sjorspeterse/Arduino_Chess/Other/Foto's/CAM00485.jpg

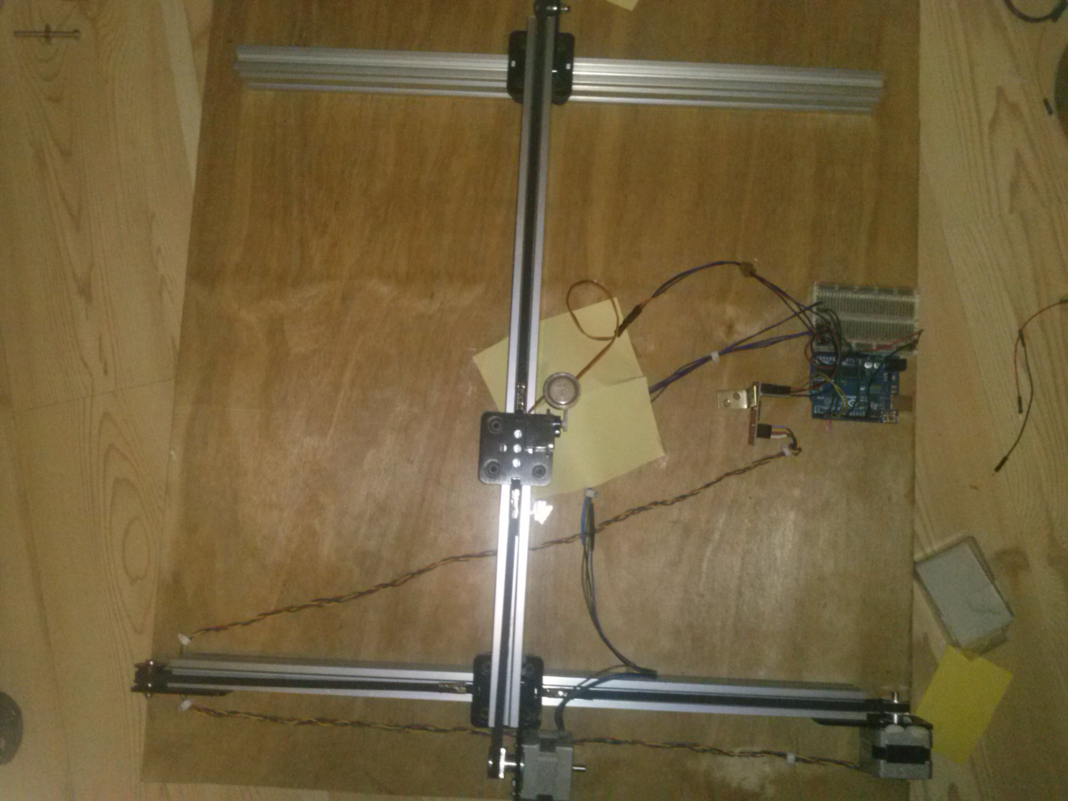
Other/Foto's/CAM00485.jpg
