sjorspeterse/Arduino_Chess/Other/Foto's/CAM00478.jpg

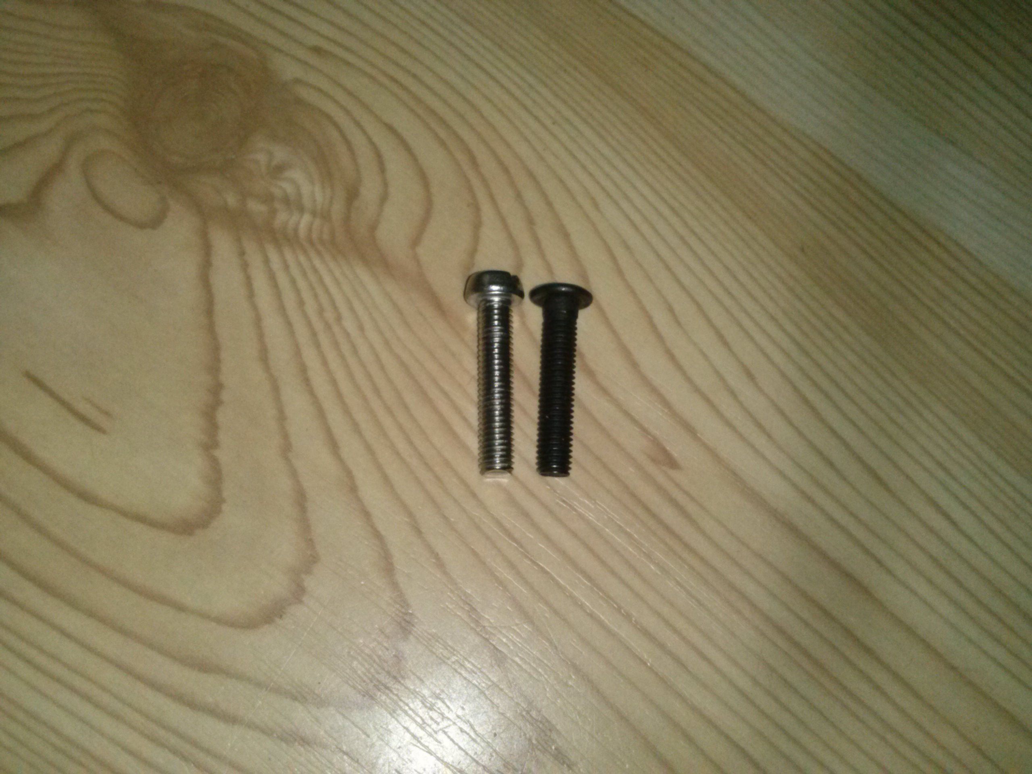
Other/Foto's/CAM00478.jpg
