sjorspeterse/Arduino_Chess/Other/bonnetjes/Floris.jpeg

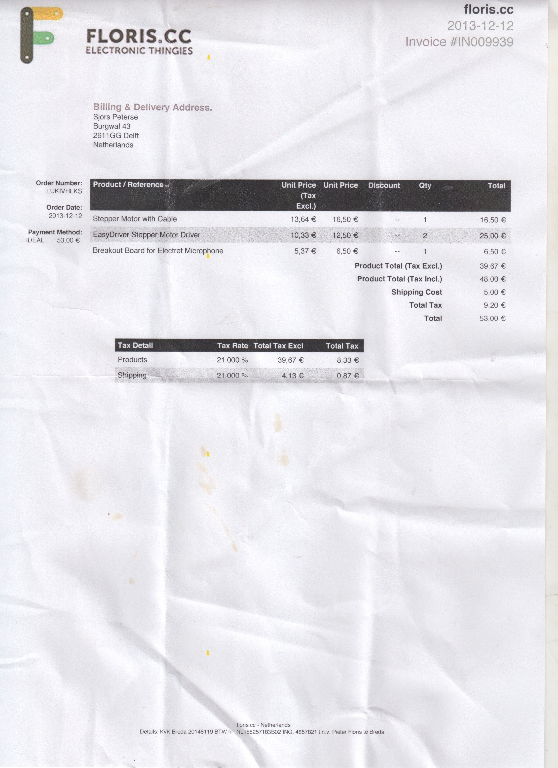
Other/bonnetjes/Floris.jpeg
