sjorspeterse/Arduino_Chess/Other/bonnetjes/HEC USB port.jpeg

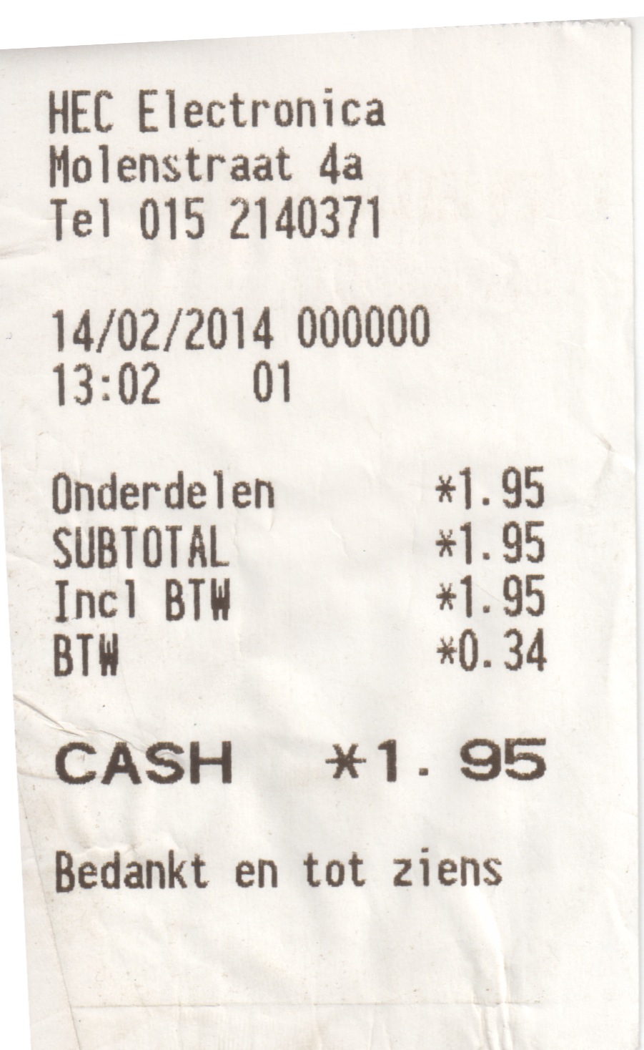
Other/bonnetjes/HEC USB port.jpeg
