sjorspeterse/Arduino_Chess/Other/bonnetjes/Invoice.jpeg

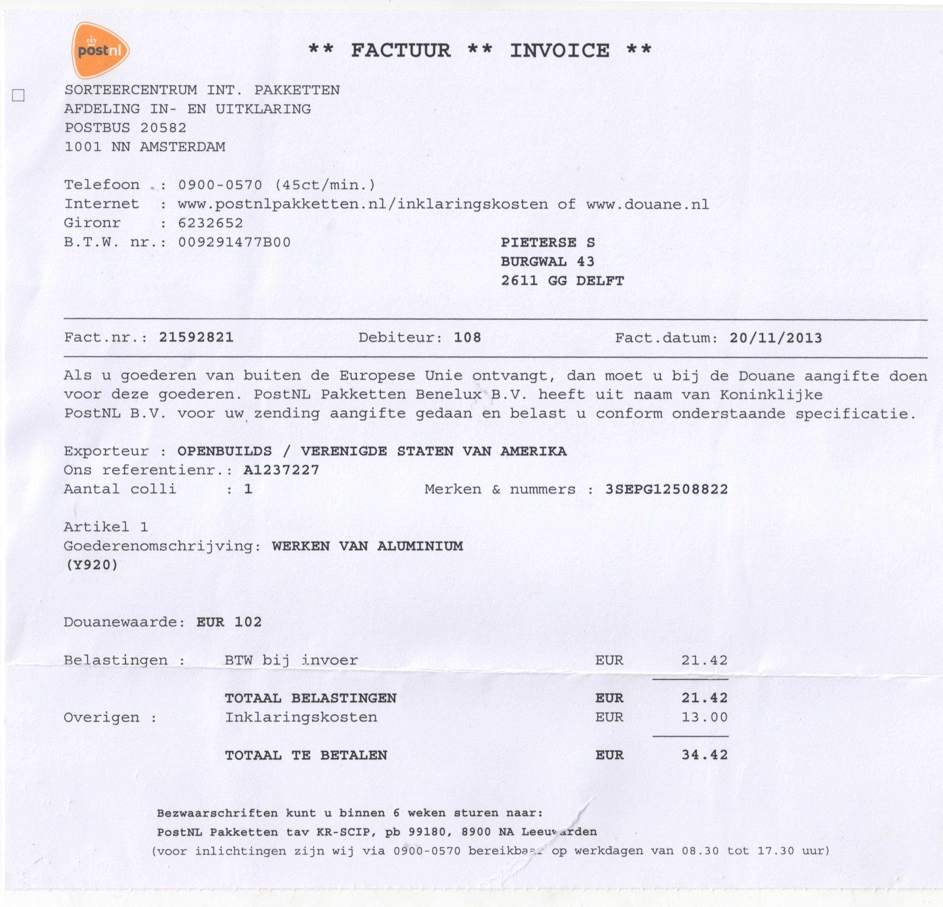
Other/bonnetjes/Invoice.jpeg
