sjorspeterse/Arduino_Chess/Other/connect.jpg

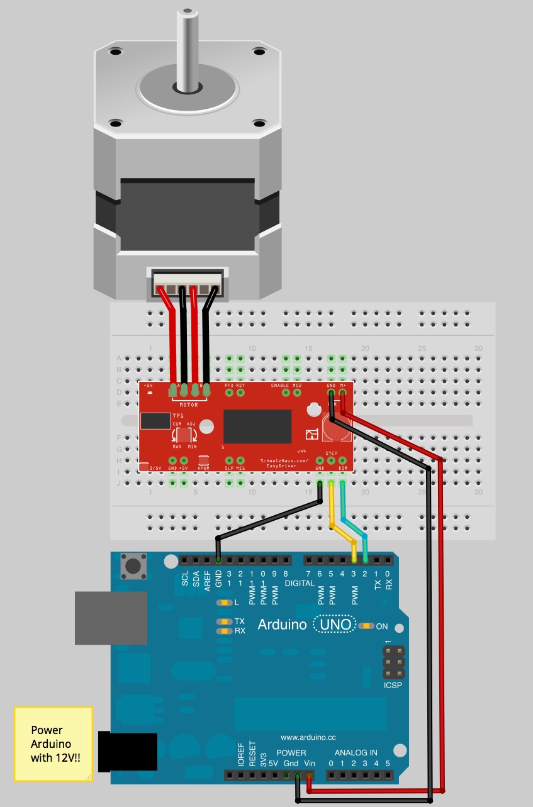
Other/connect.jpg
