sjorspeterse/Arduino_Chess/Other/Foto's/CAM00365.jpg

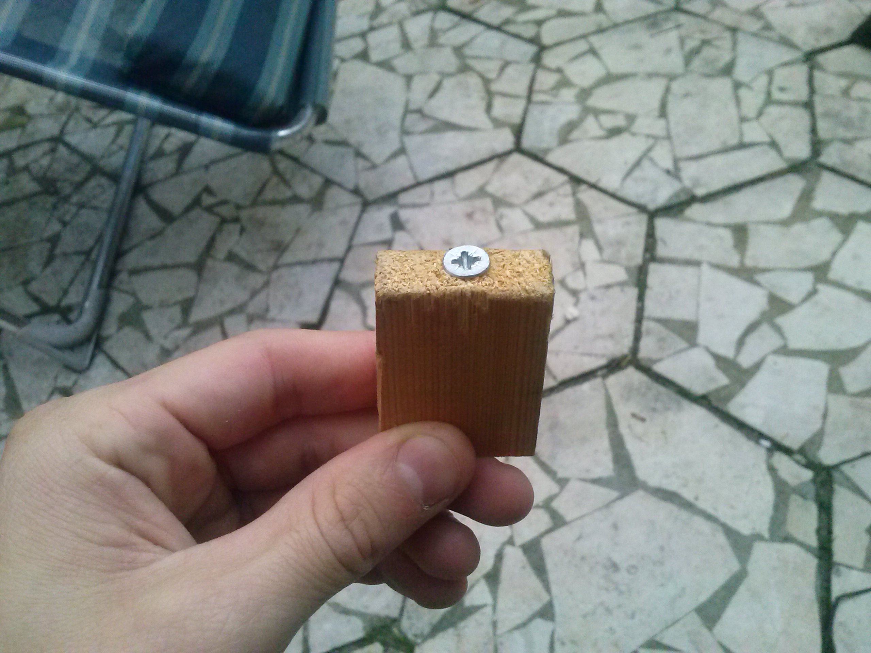
Other/Foto's/CAM00365.jpg
