sjorspeterse/Arduino_Chess/Other/Foto's/CAM00367.jpg

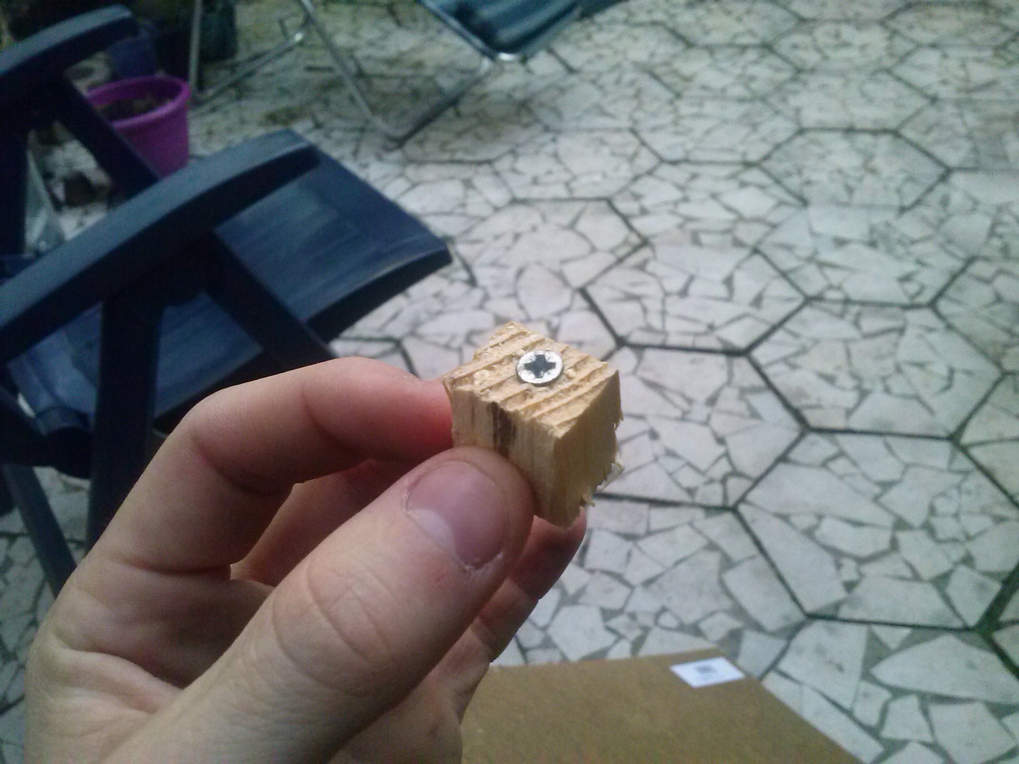
Other/Foto's/CAM00367.jpg
