sjorspeterse/Arduino_Chess/Other/Foto's/CAM00442.jpg

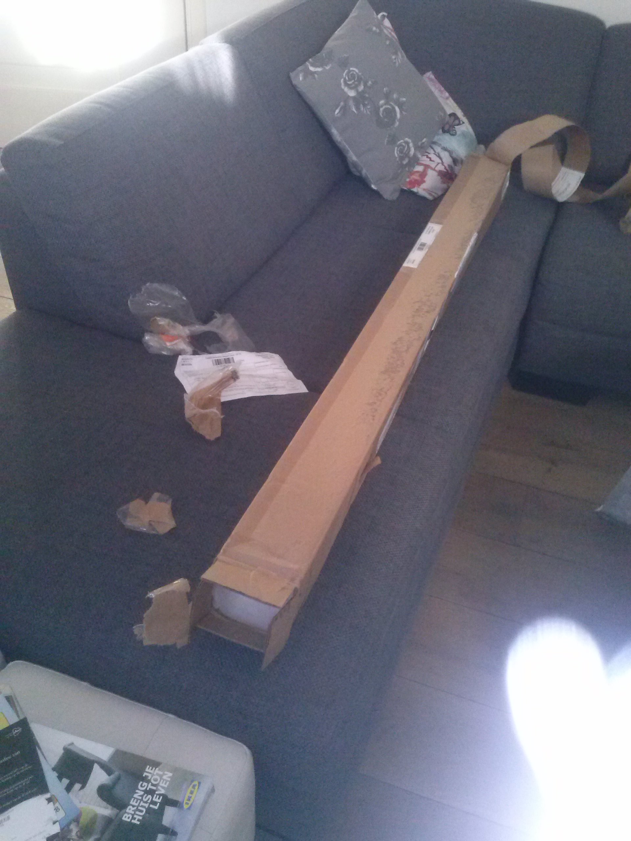
Other/Foto's/CAM00442.jpg
