sjorspeterse/Arduino_Chess/Other/Foto's/CAM00444.jpg

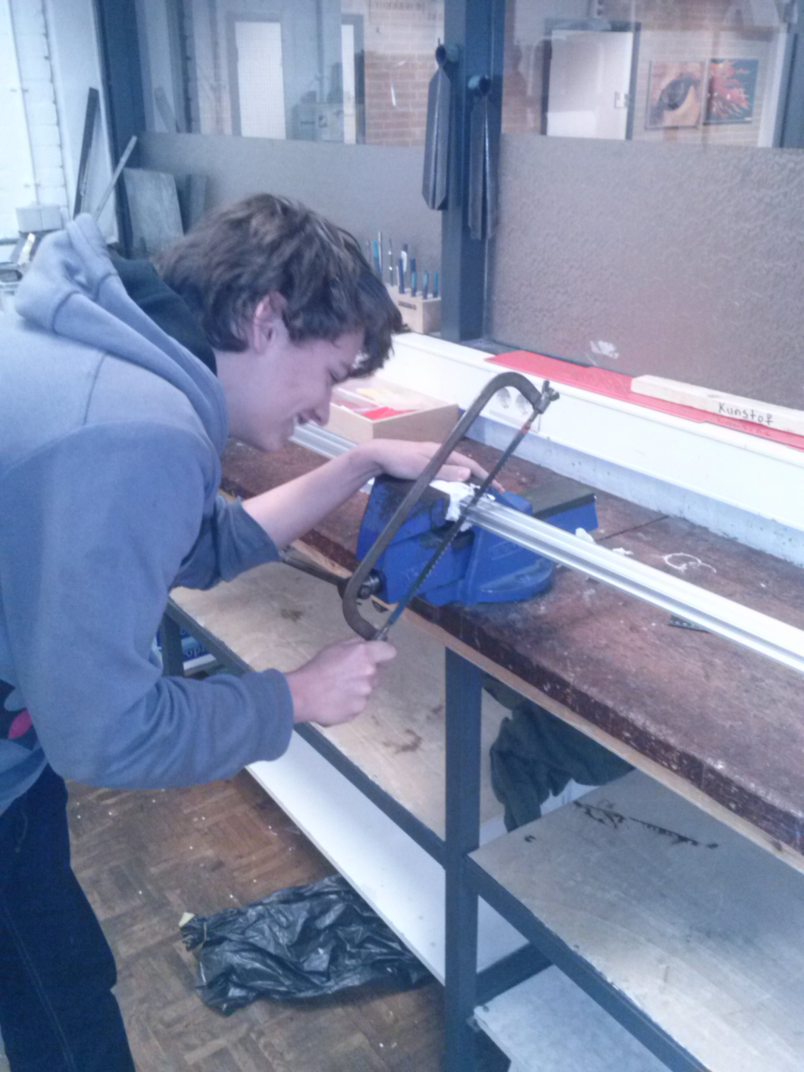
Other/Foto's/CAM00444.jpg
