sjorspeterse/Arduino_Chess/Other/Foto's/CAM00445.jpg

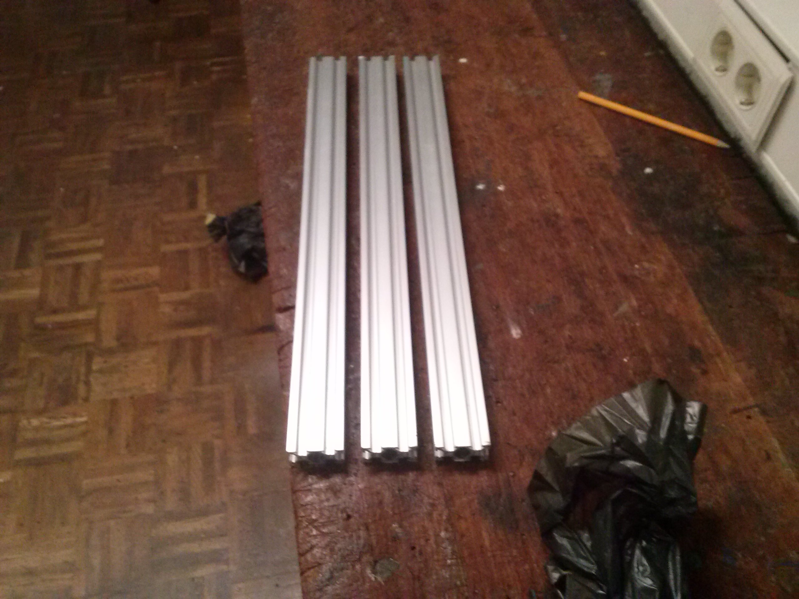
Other/Foto's/CAM00445.jpg
