sjorspeterse/Arduino_Chess/Other/Foto's/CAM00457.jpg

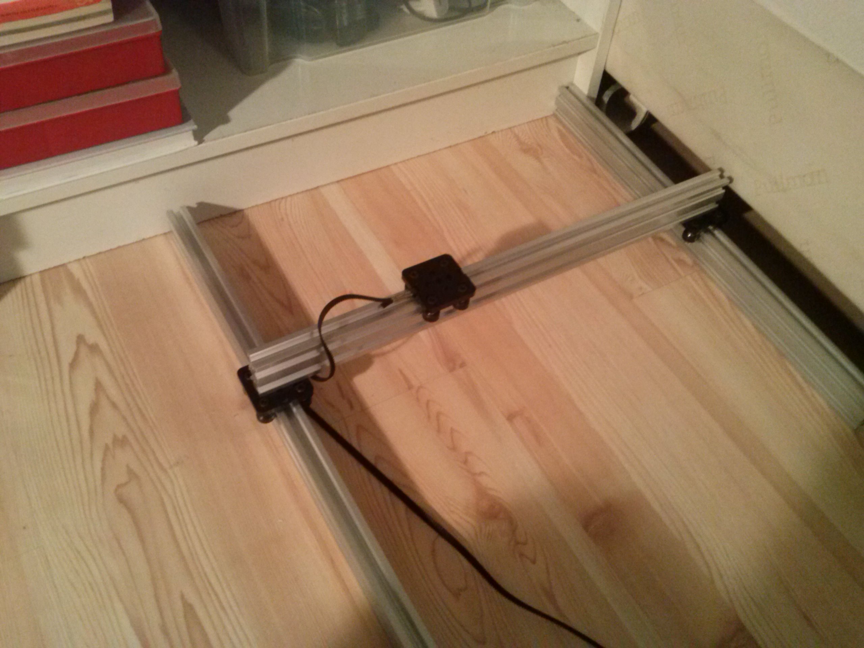
Other/Foto's/CAM00457.jpg
