sjorspeterse/Arduino_Chess/Other/Foto's/CAM00465.jpg

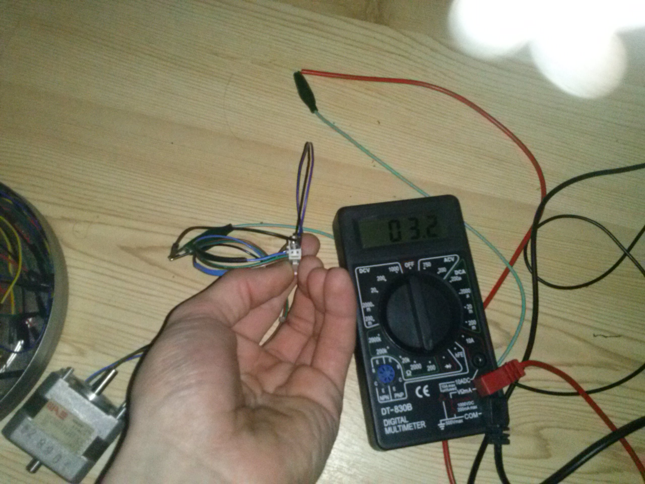
Other/Foto's/CAM00465.jpg
