sjorspeterse/Arduino_Chess/Other/Foto's/CAM00466.jpg

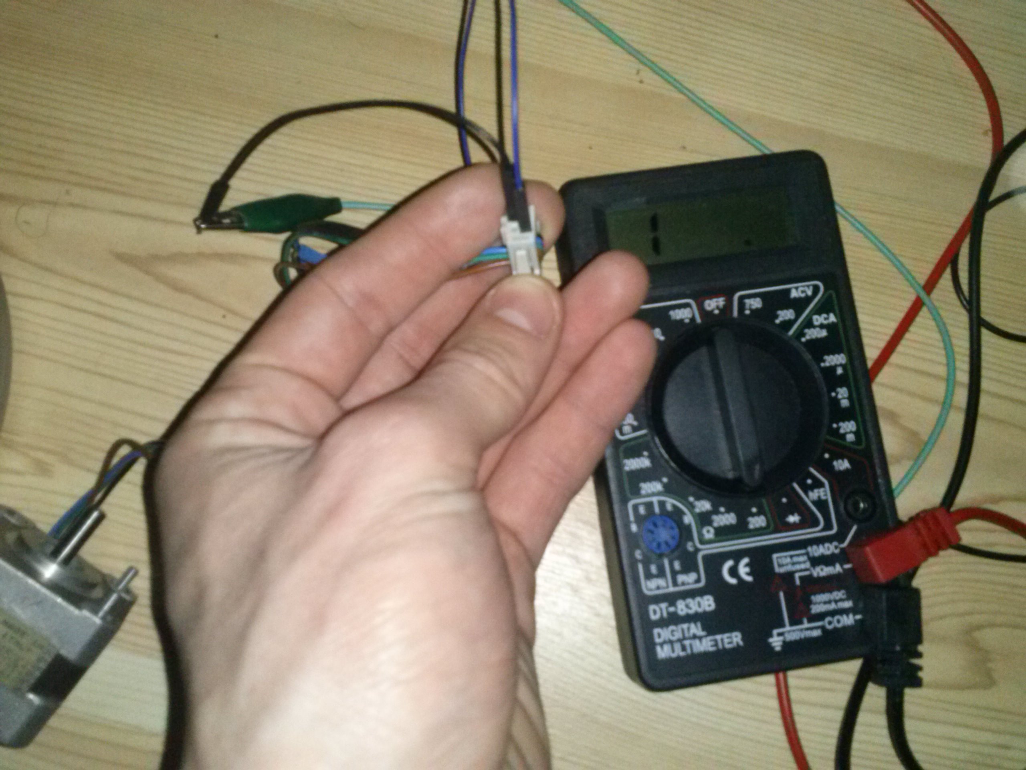
Other/Foto's/CAM00466.jpg
