sjorspeterse/Arduino_Chess/Other/Foto's/CAM00468.jpg

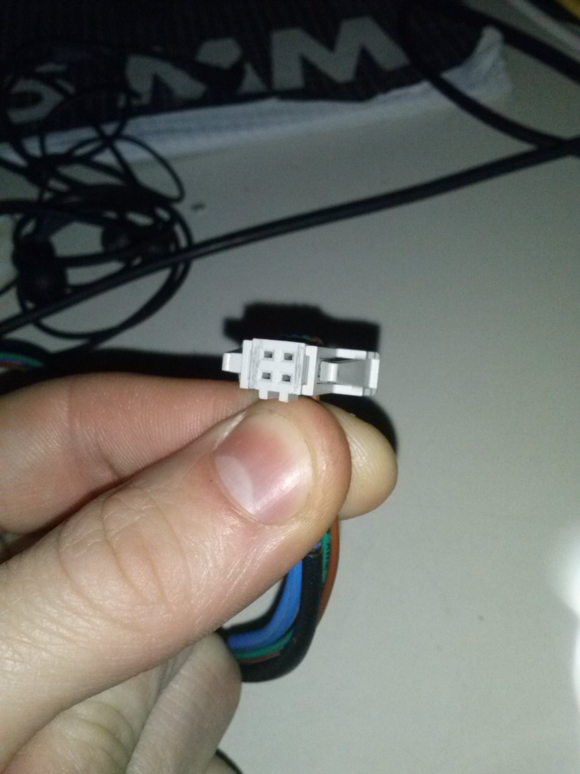
Other/Foto's/CAM00468.jpg
