sjorspeterse/Arduino_Chess/Other/Foto's/CAM00477.jpg

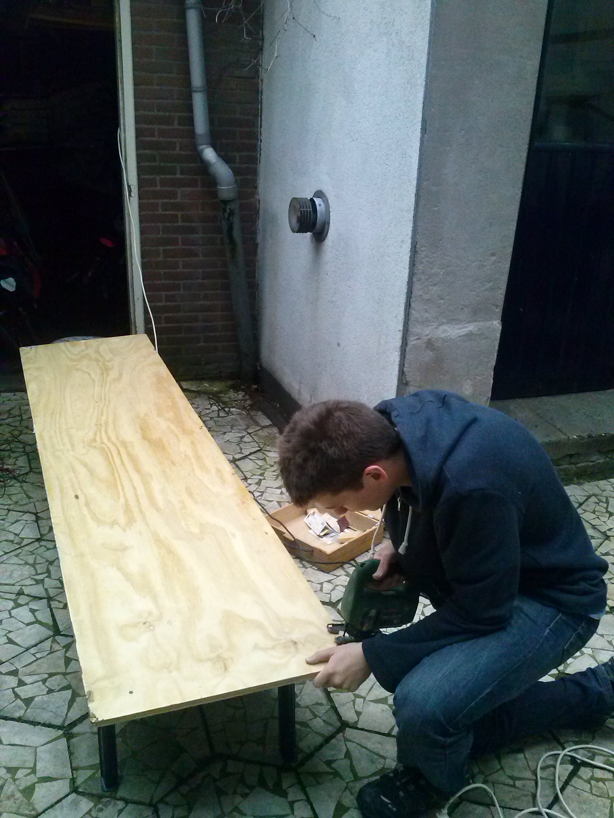
Other/Foto's/CAM00477.jpg
