sjorspeterse/Arduino_Chess/Other/Foto's/CAM00483.jpg

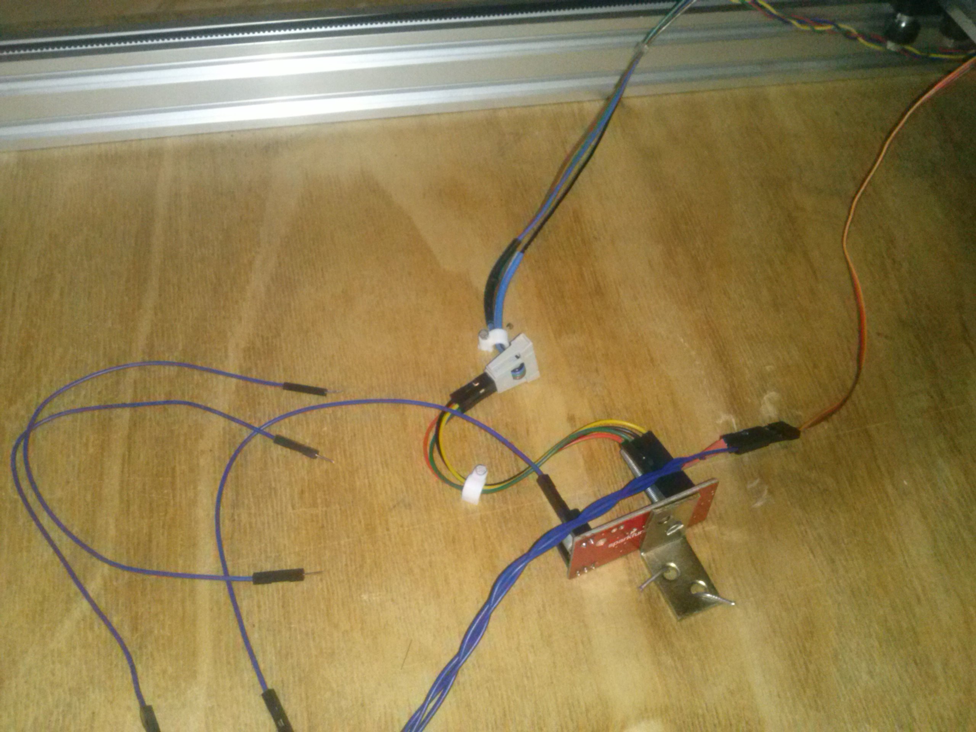
Other/Foto's/CAM00483.jpg
