sjorspeterse/Arduino_Chess/Other/Foto's/CAM00486.jpg

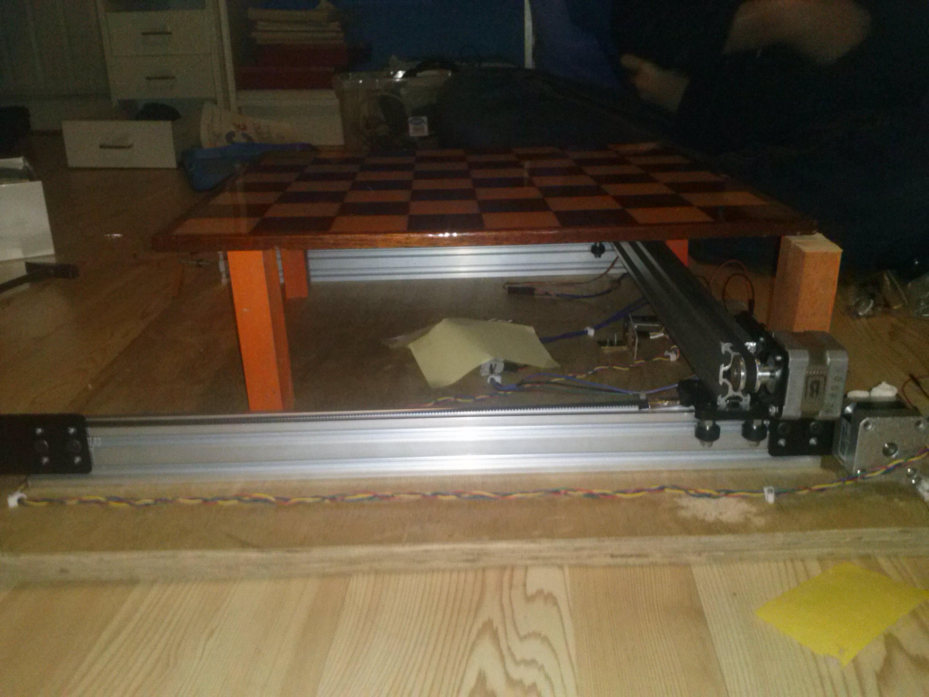
Other/Foto's/CAM00486.jpg
