sjorspeterse/Arduino_Chess/Other/Foto's/CAM00487.jpg

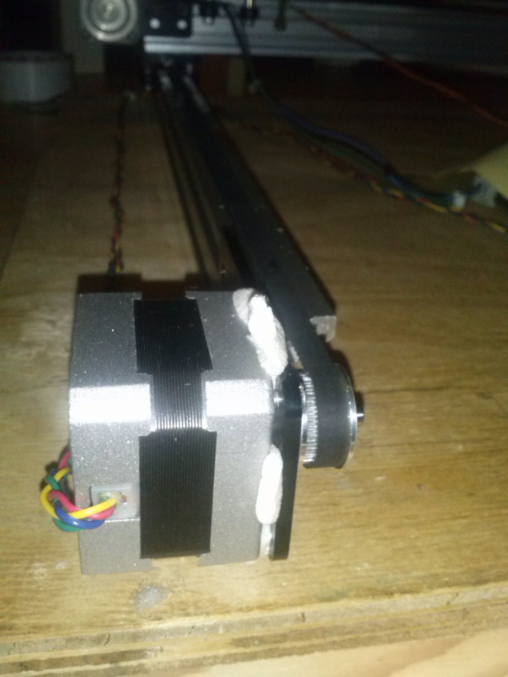
Other/Foto's/CAM00487.jpg
