sjorspeterse/Arduino_Chess/Other/Foto's/CAM00490.jpg

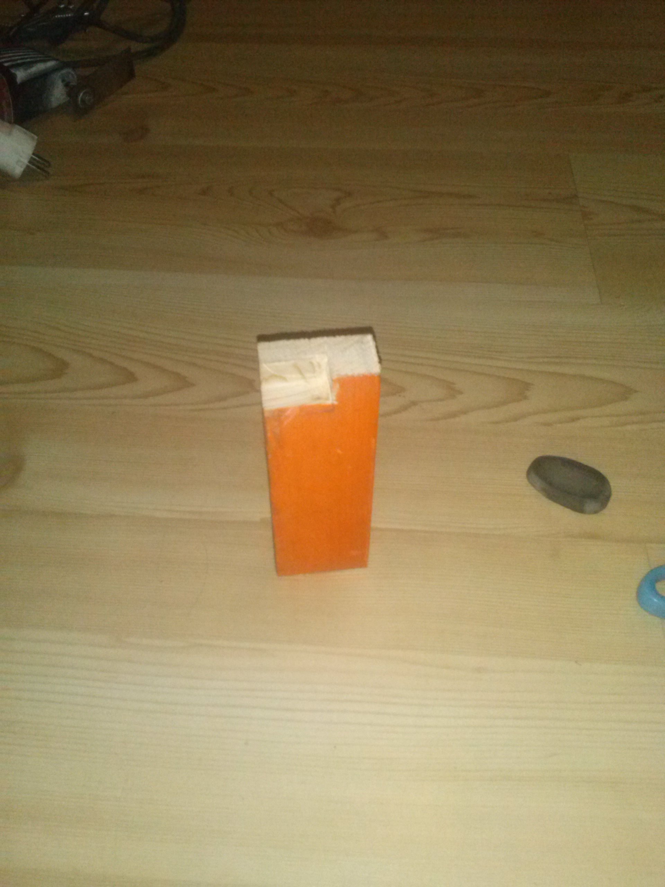
Other/Foto's/CAM00490.jpg
