sjorspeterse/Arduino_Chess/Other/Foto's/CAM00491.jpg

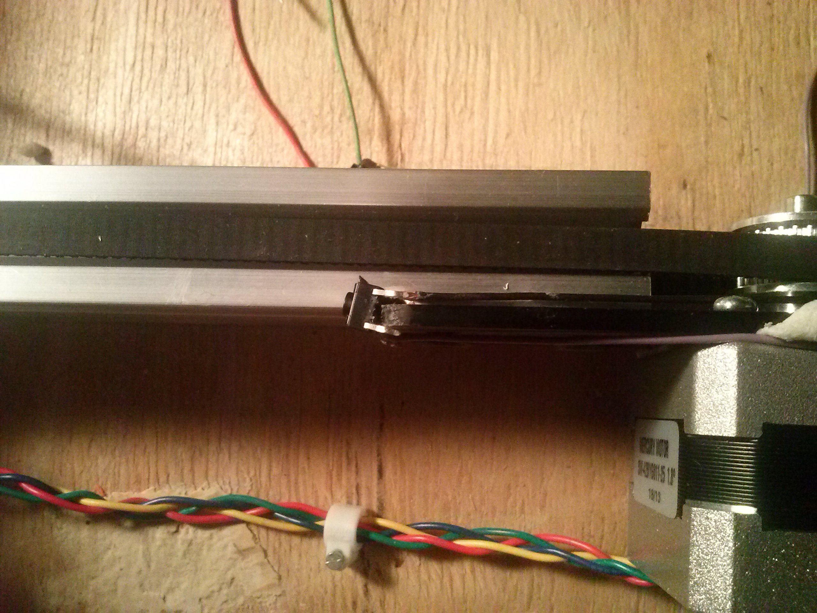
Other/Foto's/CAM00491.jpg
