sjorspeterse/Arduino_Chess/(list of files, cad)

Other CAD files:
Other/Prototype.skp
