sjorspeterse/Arduino_Chess/Parts/OpenBuildsOrder.PNG

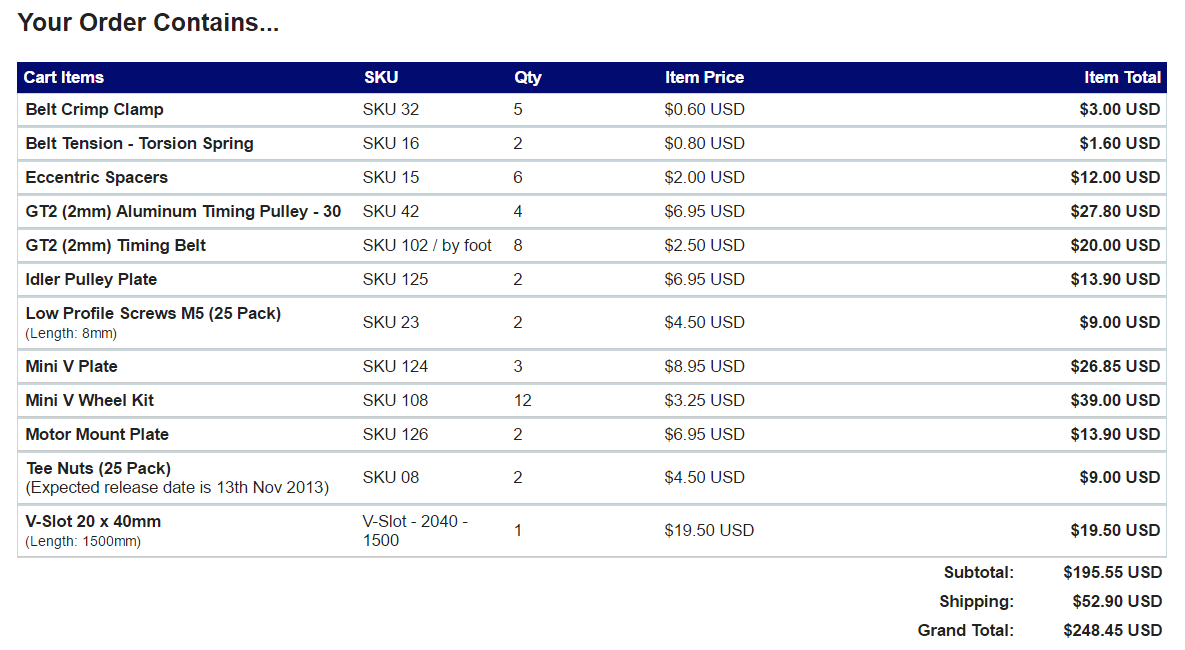
Parts/OpenBuildsOrder.PNG
